mkaiser/ESP32-CAN/Images/2023-03-17_2D_layout_draft.jpg

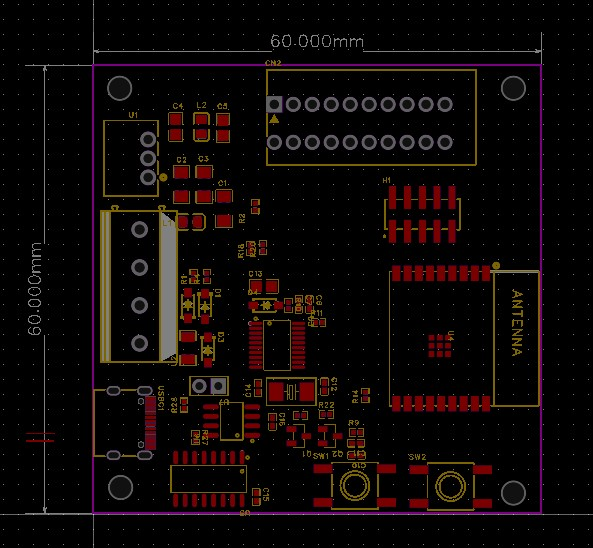
Images/2023-03-17_2D_layout_draft.jpg
