mkaiser/ESP32-CAN/Images/2023-04-10_3D_layout_draft.jpg

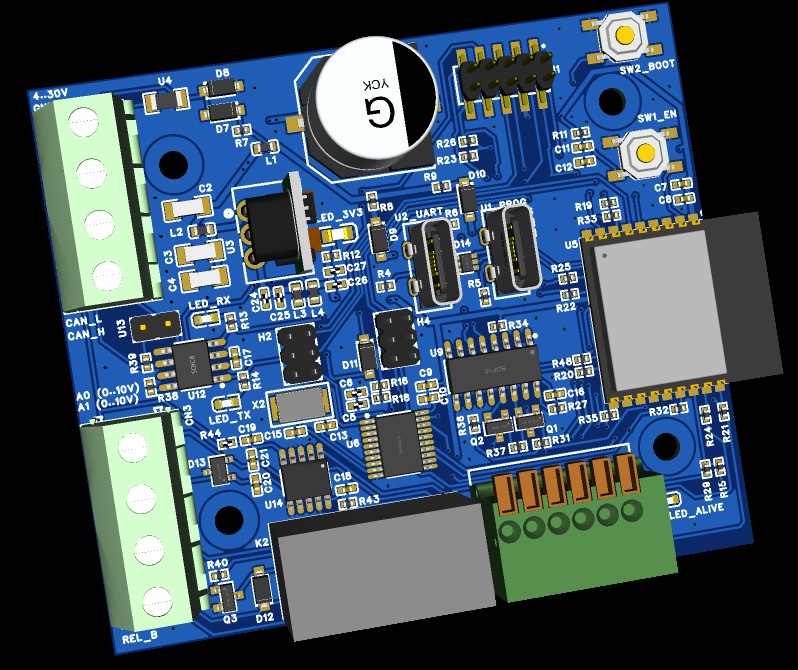
Images/2023-04-10_3D_layout_draft.jpg
