mkaiser/ESP32-CAN/Images/Sonoff_IP66_Waterproof_Junction_Box_Case.jpg

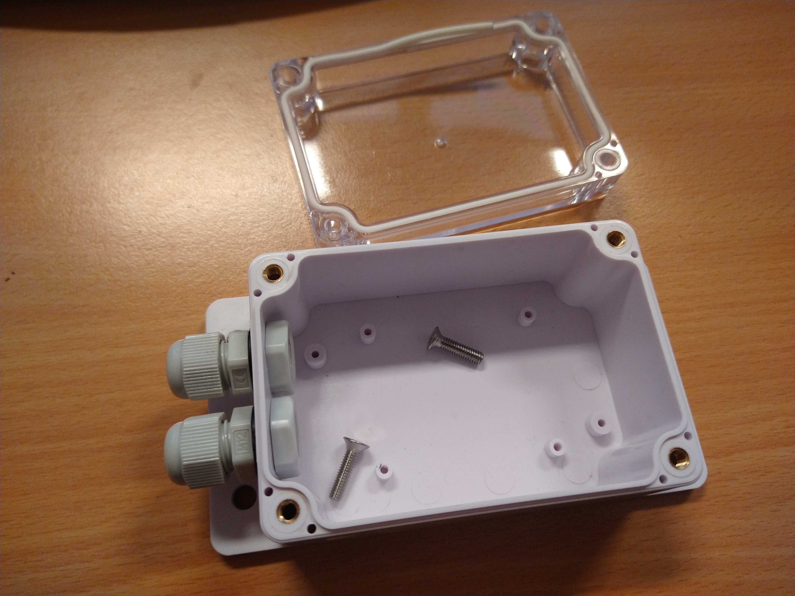
Images/Sonoff_IP66_Waterproof_Junction_Box_Case.jpg
