mkaiser/ESP32-CAN/rev1_2023-05/JLCPCB/BOM_Board1_PCB6_2023-05-23.xlsx

No. | Quantity | Comment | Designator | Footprint | Value | Manufacturer Part | Manufacturer | Supplier Part | Supplier | JLCPCB Part Class
1 | 1 | 470uF | C1 | CAP-SMD_BD12.5-L13.0-W13.0-RD | 470uF | RVT1H471M1213 | ROQANG(容强) | C90272 | LCSC | Extended Part
2 | 3 | 4.7uF | C2,C3,C4 | C1206 | 4.7uF | 1206B475K500NT | FH(风华) | C29823 | LCSC | Basic Part
3 | 8 | 10uF | C5,C6,C7,C8,C9,C12,C16,C17 | C0402 | 10uF | CL05A106MQ5NUNC | SAMSUNG(三星) | C15525 | LCSC | Basic Part
4 | 5 | 100nF | C10,C11,C14,C19,C20 | C0402_NEW | 100nF | CL05B104KO5NNNC | SAMSUNG(三星) | C1525 | LCSC | Basic Part
5 | 2 | 1uF | C13,C21 | C0402 | 1uF | CL05A105KA5NQNC | SAMSUNG(三星) | C52923 | LCSC | Basic Part
6 | 2 | 22pF | C15,C18 | C0402 | 22pF | 0402CG220J500NT | FH(风华) | C1555 | LCSC | Basic Part
7 | 2 | 10uF | C22,C23 | C0805 | 10uF | GRM21BR61H106KE43L | muRata(村田) | C440198 | LCSC
8 | 1 | 100nF | C24 | C0402 | 100nF | CL05B104KB54PNC | SAMSUNG(三星) | C307331 | LCSC | Basic Part
9 | 2 | DB128V-5.08-4P-GN-S | CN1,CN3 | CONN-TH_4P-P5.08_DIBO_DB128V-5.08 |  | DB128V-5.08-4P-GN-S | DIBO(地博电气) | C2915641 | LCSC | Extended Part
10 | 1 | KF141V-2.54-6P | CN2 | CONN-TH_6P-P2.54_KF141V-2.54-6P |  | KF141V-2.54-6P | KEFA(科发) | C475118 | LCSC | Extended Part
11 | 5 | B5819W SL | D1,D2,D4,D5,D8 | SOD-123_L2.7-W1.6-LS3.7-RD-1 |  | B5819W SL | CJ(江苏长电/长晶) | C8598 | LCSC | Basic Part
12 | 1 | SMF05CT1G | D3 | SOT-363_L2.0-W1.3-P0.65-LS2.1-BR |  | SMF05CT1G | onsemi(安森美) | C15879 | LCSC | Basic Part
13 | 1 | PSM712-LF-T7 | D7 | SOT-23-3_L3.0-W1.7-P0.95-LS2.9-BR |  | PSM712-LF-T7 | PROTEK | C32677 | LCSC
14 | 2 | DIP2X3_20_MALE | H1,H2 | HDR-TH_6P-P2.00-V-M-R2-C3-S2.00 |  | DIP2X3_20_MALE |  | C9900021892 | LCSC
15 | 1 | X4621WVS-2x05I-C40D64 | H3 | HDR-SMD_10P-P2.00-V-M-R2-C5-S2.0 |  | X4621WVS-2x05I-C40D64 | XKB Connectivity(中国星坤) | C917610 | LCSC
16 | 1 | G5Q-14 DC24 | K1 | RELAY-TH_G5Q-14-DCXX |  | G5Q-14 DC24 | OMRON(欧姆龙) | C397242 | LCSC | Extended Part
17 | 1 | 68nH | L1 | L0603 | 68nH | SDCL1608C68NJTDF | Sunlord(顺络) | C13415 | LCSC
18 | 3 | 10uH | L2,L3,L4 | L0603 | 10uH | SDFL1608S100KTF | Sunlord(顺络) | C1035 | LCSC | Basic Part
19 | 1 | NCD0805R1 | LED1 | LED0805-RD |  | NCD0805R1 | 国星光电 | C84256 | LCSC | Basic Part
20 | 3 | 19-213/Y2C-CQ2R2L/3T(CY) | LED2,LED3,LED4 | LED0603-RD |  | 19-213/Y2C-CQ2R2L/3T(CY) | EVERLIGHT(亿光) | C72038 | LCSC | Basic Part
21 | 2 | AO3401A | Q1,Q2 | SOT-23_L2.9-W1.3-P1.90-LS2.4-BR |  | AO3401A | AOS | C15127 | LCSC | Basic Part
22 | 2 | DMMT3906W-7-F | Q3,Q4 | SOT-363_L2.0-W1.3-P0.65-LS2.1-BR |  | DMMT3906W-7-F | DIODES(美台) | C151567 | LCSC | Extended Part
23 | 4 | MMBT3904 | Q5,Q6,Q8,Q9 | SOT-23-3_L2.9-W1.3-P1.90-LS2.4-BR |  | MMBT3904 | CJ(江苏长电/长晶) | C20526 | LCSC | Basic Part
24 | 1 | 2N7002 | Q7 | SOT-23-3_L2.9-W1.3-P1.90-LS2.4-BR |  | 2N7002 | CJ(江苏长电/长晶) | C8545 | LCSC | Basic Part
25 | 4 | 0402WGF5101TCE | R1,R2,R4,R5 | R0402 |  | 0402WGF5101TCE | UNI-ROYAL(厚声) | C25905 | LCSC | Basic Part
26 | 15 | 0Ω | R3,R22,R23,R24,R26,R27,R29,R30,R31,R33,R34,R35,R38,R40,R42 | R0402 | 0Ω | SCR0402J0R | VO(翔胜) | C17168 | LCSC
27 | 6 | 10kΩ | R6,R7,R12,R17,R18,R20 | R0402 | 10kΩ | 0402WGF1002TCE | UNI-ROYAL(厚声) | C25744 | LCSC | Basic Part
28 | 2 | 68kΩ | R8,R9 | R0402 | 68kΩ | 0402WGF6802TCE | UNI-ROYAL(厚声) | C36871 | LCSC | Basic Part
29 | 2 | 100kΩ | R10,R11 | R0402 | 100kΩ | 0402WGF1003TCE | UNI-ROYAL(厚声) | C25741 | LCSC | Basic Part
30 | 4 | 2kΩ | R13,R14,R15,R16 | R0402 | 2kΩ | 0402WGF4703TCE | UNI-ROYAL(厚声) | C4109 | LCSC | Basic Part
31 | 3 | 1kΩ | R19,R43,R44 | R0402 | 1kΩ | 0402WGF1001TCE | UNI-ROYAL(厚声) | C11702 | LCSC
32 | 1 | 510Ω | R21 | R0402 | 510Ω | 0402WGF2202TCE | UNI-ROYAL(厚声) | C25123 | LCSC | Basic Part
33 | 3 | 4.7kΩ | R25,R28,R36 | R0402 | 4.7kΩ | 0402WGF4701TCE | UNI-ROYAL(厚声) | C25900 | LCSC
34 | 2 | 12kΩ | R32,R37 | R0402 | 12kΩ | 0402WGF1202TCE | UNI-ROYAL(厚声) | C25752 | LCSC | Basic Part
35 | 2 | 120Ω | R39,R41 | R0402 | 120Ω | 0402WGF1200TCE | UNI-ROYAL(厚声) | C25079 | LCSC
36 | 2 | TS-1187A-B-A-B | SW1,SW2 | SW-SMD_4P-L5.1-W5.1-P3.70-LS6.5-TL-2 |  | TS-1187A-B-A-B | XKB Connectivity(中国星坤) | C318884 | LCSC | Basic Part
37 | 1 | K78L03-500R3 | U1 | PWRM-TH_K78LXX-500R3 |  | K78L03-500R3 | MORNSUN(金升阳) | C115818 | LCSC | Extended Part
38 | 2 | TYPE-C 16PLC-H10.0 | U2,U3 | TYPE-C-TH_16PLC-H10.0 |  | TYPE-C 16PLC-H10.0 | SHOU HAN(首韩) | C3151747 | LCSC | Extended Part
39 | 1 | TLC-NSMD005 | U4 | R1206 |  | TLC-NSMD005 | TLC(竞沃) | C261946 | LCSC | Extended Part
40 | 2 | 2.54-1*2 | U5,U9 | HDR-TH_2P-P2.54-V-M |  | 2.54-1*2 | ZHOURI(洲日) | C5116481 | LCSC | Extended Part
41 | 1 | ESP32-C3-WROOM-02-N4 | U6 | BULETM-SMD_ESPRESSIF_ESP32-C3-WROOM-02-N4-4MB |  | ESP32-C3-WROOM-02-N4 | ESPRESSIF(乐鑫) | C2934560 | LCSC | Extended Part
42 | 1 | CH340C | U7 | SOP-16_L10.0-W3.9-P1.27-LS6.0-BL |  | CH340C | WCH(南京沁恒) | C84681 | LCSC | Extended Part
43 | 1 | SN65HVD230DR | U8 | SOIC-8_L4.9-W3.9-P1.27-LS6.0-BL |  | SN65HVD230DR | TI(德州仪器) | C12084 | LCSC | Basic Part
44 | 1 | GP8403-TC50-EW | U10 | ESSOP-10_L4.9-W3.9-P1.0-LS6.0-BL |  | GP8403-TC50-EW | Guestgood(客益) | C3152007 | LCSC | Extended Part
45 | 1 | MCP2515-I/SO | U11 | SOIC-18_L11.6-W7.5-P1.27-LS10.3-BL |  | MCP2515-I/SO | MICROCHIP(美国微芯) | C12368 | LCSC | Extended Part
46 | 1 | 8MHz | X1 | CRYSTAL-SMD_L5.0-W3.2 | 8MHz | X50328MSB2GI | YXC(扬兴晶振) | C115962 | LCSC | Basic Part
