mkaiser/ESP32-CAN/Simulation/Simulation_back_powering_zero_voltage_diode.asc

D1: diode; 1N4148
M1: pmos; Si4465DY
Q1: pnp; BC556B
Q2: pnp; BC556B
R1: res; 65K
R2: res; 100K
R4: res; 500R
R5: res; 10K
S1: sw; EN_24V
S2: sw; EN_5V
V1: voltage; 5V
V2: voltage; 24V
V3: voltage; PULSE(0 1 0.05 5m 5m 0.075 0.15 2)
V4: voltage; PULSE(0 1 10m 1m 1m 50m 100m 3)
Named nets: 0, USB_IN, 5V-24V, M1G, Q1G
.tran 5 startup
0603
0603
.model EN_24V SW(Ron=1 Roff=1Meg Vt=.5 Vh=-.4)
.model EN_5V SW(Ron=1 Roff=1Meg Vt=.5 Vh=-.4)
