mkaiser/ESP32-CAN/rev1_2023-05/2023-07-14._Schematic_rev0_errata_.pdf

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
VREF

5

CANL

6

CANH

7

RS

8

U8

SN65HVD230DR

External power supply (laying out for 5V-30V)

optional 120 Ohm termination via Jumper.
Only required, if the bus is not terminated, yet on BOTH sides. Leave open, if this device
is added to an existing system.

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
2.54-1*2
CAN_H
CAN_L

GND

3V3

TXCAN

RXCAN

MCP_RXCAN

MCP_TXCAN

GND

standard 5.08 mm pitch
screw terminal
Connectors | Power multiplexing:
| CAN OR USB OR USB

# CAN Controller

# 3V3 CAN transceiver

# ESP32 C3 as

LED | System on Module

MCP_CS_N
MCP_MISO
MCP_MOSI

red for power

yellow for RX, TX and ESP alive indicator

LED3

19-213/Y2C-CQ2R2L/3T(CY)

The CAN Bus of my Tecalor TTF 07 cool heatpump operates at 5V.
Fortunately, CAN is designed to support a mixed 3V3 and 5V operation: https://www.analog.com/en/technical-articles/can-bus-transceivers-operate-from-33v-or-5v-and-withstand-60v-faults.html (Analog.com is a well-established manufacturer. They know what they are publishing!)
--> This means we can use a 3V3 transceiver and can be on the same 3V3 powerrail as the ESP. No need to go to mixed 3V3 / 5V

3V3

LED1
NCD0805R1

GND

R39

120

GND

GND

LED2
19-213/Y2C-CQ2R2L/3T(CY)

### Reviewed

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
A | A
B | B
C | C
D | D

### Drawed

### VER

### Create Date Part Number

PAGE | OF

### Schematic

### Update Date

### SIZE

### Page

## Martin Kaiser

V0.3 | A2

# ESP32_CAN

1

2023-07-14
2023-03-05

# ESP_CAN

1

## main

R18
10k
R19

1k

GND

100nF

C11

10uF

C12 GND

RSlope GND = always high speed (never power save/ IDLE)

0 Ohm resistors,
to shut one power off completely and as testpoints

# Power Supply

CAN_H

CAN_L

GND

# CAN Bus / PWR In

GND

24V_IN

30V 50mA 自恢复

U4

TLC-NSMD005
D2
B5819W SL
40V 1A 600mV@1A

resettable fuse
supports max 30V
trip current: 150mA @CAN_VIN @16V this means up to 2.4 Watt

# CAN Bus

LED4
19-213/Y2C-CQ2R2L/3T(CY)

# GNDGPIO⁰_ESP_LED

10uF

C9 C10 100nF

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
100nF

EN

Chip Enable
Press to disable device

GND

Boot option

VCC 16
R232 15
RTS# 14
DTR# 13
DCD# 12
RI# 11
DSR# 10
CTS# 9 NC. 8

NC. 7

D- 6

D+ 5

V3 4

RXD 3

TXD 2

GND 1

U7

CH340C

# USB to UART (backup if native USB fails)

C19
100nF

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
Magic to enter boot mode via USB

Q5

MMBT3904

Q6

MMBT3904

MCP_CS_N R30
0

R34
0

IO2

IO10_SCLK

R23
0

IO0

RESET_N R26
0

IO1

INT_N R33
0

IO3

IO9_BOOT

100nF

C20

some GPIO to spring connector

VIN

1

GND

2

VOUT

3

U1
K78L03-500R3

CAN_V_IN

CAN_V_IN

# 4.75V-36V to 3V3

5V_TO_30V_IN

GND

3V3

C2

4.7uF 10% 50V

C3 | C4 4.7uF 10% ⁵⁰V

3V3

R35
0

3V3

The DTR# pin of CH340 is used as a configuration input pin before the USB configuration is complete. An external 4.7K pull-down resistor can be connected with this pin to generate default low level during USB enumeration, apply larger supply current to the USB bus via the configuration descriptor.

R36
4.7k

DTR

R29
0

use 2x 4.7uF
instead of 1x10uF

# USB C Prog

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
IO19

14
IO18

13
TXD

12
RXD

11
IO10

10 GND

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
ESP32-C3-WROOM-02-N4

IO6_MISO
IO7_MOSI

TDI_IO5

TMS_IO4

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
see https://www.espressif.com/sites/default/files/documentation/esp32-c3-wroom-02_datasheet_en.pdf Fig 7 Peripheral Schematics

2x5 pol 2mm MySensors wired connector (want to re-use the board for other projects)

footprint should fit
WSL 2X05SMD 2,00

1

1

10 10

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
X4621WVS-2x05I-C40D64

3V3

GND

GND

GND

# Unrelated to CAN for testing and multi purpose

3-way Solderbriges to route MISO / MOSI
to MCP, directly to CAN or to the Mys connector. generates ugly stubs, but the CAN is driven very slowly...

datasheet is shit....
will use 0ohm in case...

# WARNING:

This revision has been manufactured and tested.

# There were some minor bugs. The bugs are annotated in this version

# USB C UART

USB_UART_N

USB_UART_P

USB 2 data TVS protection
https://www.ti.com/lit/an/slvaf82a/slvaf82a.pdf?ts=1680426390162&
1 | 2
3 | 4

SW1
TS-1187A-B-A-B
1 | 2
3 | 4

SW2
TS-1187A-B-A-B

EN

SCLK 1
SDA 2
A0 3
A1 4
VCC 5 | GND

6

VOUT1

7

VOUT0

8

A2

9

V5V

10

U10

GP8403-TC50-EW

C18

22pF

C15

22pF

datasheet is very unreadable.
Translation here:
https://dfimg.dfrobot.com/nobody/wiki/79daa2f3c729e78f0580b474fe33a5e3.pdf

1x relay output for bypass control

C1
470uF

10uH 10% 3mA 1.85
L2

68nH 5% 850m

L1

including EMC compliance

use 2x 10uH
instead of 1x22uH

10uH 10% 3mA 1.85

L3

10uH

L4

10uH

RX/TX swap

IO10_SCLK

USB_PROG_P
USB_PROG_N

IO3

IO1

IO0

datasheet is shit....
will use 0ohm in case...

USB_RX

USB_TX

IO8

TMS_IO4

R24
0

R27
0

R31
0

TDI_IO5

# Configuration / multi purpose / Debugging

from ESP to
MCP or MYS

from MCP or ESP
to CAN transceiver

from MCP or MYS
to ESP

MOSI / TX

MISO / RX

ESP-side | CAN-side

R22
0

USB_RX

USB_TX
ESP_RX
ESP_TX

GPIO1_ESPIO8

SCLK

SCL_ESPIO4

RESET_N

SCLK

MYS_MISO

INT_N

SDA_ESPIO5

GPIO1_ESPIO8
MYS_MOSI

SCL_ESPIO4

GPIO0_ESP_LED

R25

4.7k
R28

4.7k

3V3

B10 B10
B2 B2
A10 A10
A2 A2
GND B12
VBUS B9
SBU2 B8
D- B7
D+ B6

CC2 B5 VBUS B4 GND B1 GND A12 VBUS A9 SBU1 A8 D- A7 D+ A6 CC1 A5 VBUS A4 GND A1

U2

TYPE-C 16PLC-H10.0

R1

5.1K (5101) 1% 编带

GND

GND
5V_USB_PROG

5V_USB_PROG

USB_PROG_N

USB_PROG_P GND
GND

R4
5.1K (5101) | 1% 编带
| GND

5V_USB_PROG

USB_PROG_P

USB_PROG_N

B10 B10
B2 B2
A10 A10
A2 A2
GND B12
VBUS B9
SBU2 B8
D- B7
D+ B6

CC2 B5 VBUS B4 GND B1 GND A12 VBUS A9 SBU1 A8 D- A7 D+ A6 CC1 A5 VBUS A4 GND A1

U3

TYPE-C 16PLC-H10.0

R2

5.1K (5101) 1% 编带

GND

GND
5V_USB_UART

5V_USB_UART

USB_UART_N

USB_UART_P GND
GND

R5
5.1K (5101) | 1% 编带
| GND

5V_USB_UART

USB_UART_P

SDA_ESPIO5

SCL_ESPIO4

ADDR2

GND

TVS 10V

GND

R42
0

GND

GND

WANRING. No variants in EasyEDA. If you need another I2C address, you need to remove the 0Ohm and solder a wire to 3V3

from CAN transceiver to
to MCP or ESP

D7
PSM712-LF-T7

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
DB128V-5.08-4P-GN-S

REL_A

A1_OUT | standard 5.08 mm pitch screw terminal

A0_OUT

REL_B

REL_A
ADDR2

C21
1uF
D8
B5819W SL

24V_IN

Q7
2N7002

GND

R41

120

I2C Pullups

Datasheet says 9V-36V

GPIO1_ESPIO8

# Unrelated to CAN control ventilation (TVZ 170 e plus) via 2x 0..10V analog out and 1 potential free relay to control the bypass

5

4

1

2

3
K1
G5Q-14 DC24

REL_B

1

2

3 | 4
| 5

6

D3

SMF05CT1G

USB_PROG_P

USB_UART_P | USB_PROG_N

USB_UART_N

GND

X1
8MHz

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
Extended Part
DB128V-5.08-4P-GN-S

24V_IN

C5
10uF | 20% 6.3V
| 10uF 20% 6.3V C6
10uF 20% 6.3V

C7

10uF 20% 6.3V

C8

C16
10uF

C17
10uF
Hardware design guidelines:
2.6 UART
You need to connect a 499 resistor to the U0TXD line to suppress the 80 MHz harmonics.
Using 510Ohm basic part

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
KF141V-2.54-6P

SDA_ESPIO5
GPIO0_ESP_LED

USB_UART_N

3V3

GND

GPIO1_ESPIO8

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
DIP2X3_20_MALE

MCP_MISO
IO6_MISO
MYS_MISO | IO6_MISO MCP_RXCAN
| RXCAN

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
DIP2X3_20_MALE

IO7_MOSI

MCP_MOSI
MYS_MOSI

TXCAN

MCP_TXCAN
IO7_MOSI

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
B5819W SL

R3
0

CAN Bus reverse current protection.

5V_TO_30V_IN

24V_IN
reverse polarity & short protection

Voltage drop by a diode is not okay here (5V (USB) - 0.7V (diode) < 4.75V required by DC-DC converter) Creating an ideal diode, inspired by https://electronics.stackexchange.com/a/524772
and https://www.electro-tech-online.com/articles/simple-inexpensive-ideal-diode-mosfet-circuits.817/ see LTspice simulation files

R40
0

using two MATCHED
PNP transistors
as current mirror
(badly drawn here, sorry)
1

2

4 | 3
5
6

Q3

DMMT3906W-7-F

Q1

AO3401A

5V_TO_30V_IN

5V_USB_UART

GND

1

2

4 | 3
5
6

Q4

DMMT3906W-7-F

Q2

AO3401A

GND

5V_USB_PROG

0.7V voltage drop is neglecible here.
Simply using a diode for backcurrent protection

R10
100k

R8
68k

D4
B5819W SL

R6
10k

Pin header to
validate backcurrent

1

1

2

2
2.54-1*2

U5

5V_TO_30V_IN

D5
B5819W SL

R9
68k
R11
100k

R7
10k

C24
100nF 10% 50V

C23
10uF 10% 50V

C22
10uF 10% 50V

A1_OUT

A0_OUT

TXCAN

1
RXCAN

2
CLKOUTSOF

3
TX0RTS#

4
TX1RTS#

5
TX2RTS#

6
OSC2

7
OSC1

8
VSS

9
RX1BF#

10

RX0BF#

11

INT#

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
RESET#

17

VDD

18

U11

MCP2515-I/SO

SCLK
INT_N

RESET_N

Q8
MMBT3904 | Q9
| MMBT3904

3V3

3V3

R43

1k

R44

1k

RXCAN
TXCAN
IO9_BOOT

SDA_ESPIO5

SCL_ESPIO4

300mA

These Inductors have a
max current limit of 3mA...
We need around 300mA here, assuming 1W max. peak power. --> Bypass them in PCB prototype

The UART RX/TX lines are
double crossed here...
desolder Resistors and
use thread wire

Alive LED "LED4"
should be driven via transistor.
This way it could interfere with the RTS / DRT circuit (but it works in practise!)

RX CAN LED is logical '1', if
the bus is IDLE
--> Change circuit to drive the LED active low (just blink, if there is ongoing communication)

TX LED can be ommited.
RX LED is covering also TX
