mkaiser/ESP32-CAN/(commit log)

2023-03-17 initial commit: Schematics draft, some Layout considerations
    [2023-03-17_BOM_draft.xlsx]
2023-04-06 added current draft (not finished, yet)
    [2023-04-06_BOM_draft.xlsx]
2023-04-10 placement & routing finished for Sonoff case
    [2023-04-10_BOM_draft.xlsx]
2023-04-20 Design is ready for manufacturing
    - found & fixed some bugs
    -- use ideal diodes instead of simple diodes to prevent voltage drop from 5V below 4.75V (min voltage reg)
    -- use 50V capable capacitors instead of 6.3V capable for 10V analog output stuff and its 24V power supply
    -- use MCP2515 in a larger SO package (TSSOP was not available any more)
    - removed old schematics as they contain errors
    - updated doc
    [2023-03-17_BOM_draft.xlsx, 2023-04-06_BOM_draft.xlsx, 2023-04-10_BOM_draft.xlsx, BOM_Board1_ESP_CAN_2023-04-20.xlsx, BOM_Board1_ESP_CAN_2023-04-20_trimmed.xlsx, PickAndPlace_PCB6_2023-04-20.xlsx]
2023-04-20 Included the case drawing and tried to scale it (did not work...)
2023-07-14 Update documentation, schematic errata, manufacturing data of rev 0
    [BOM_Board1_ESP_CAN_2023-04-20.xlsx, BOM_Board1_ESP_CAN_2023-04-20_trimmed.xlsx, BOM_Board1_PCB6_2023-05-23.xlsx, PickAndPlace_PCB6_2023-04-20.xlsx, PickAndPlace_PCB6_2023-05-23.xlsx]
2023-07-14 Add info about badly placed Pin header
